JysusCrack2321/AeroPendulo/control/figuras/diagrama_bloques_pid.png

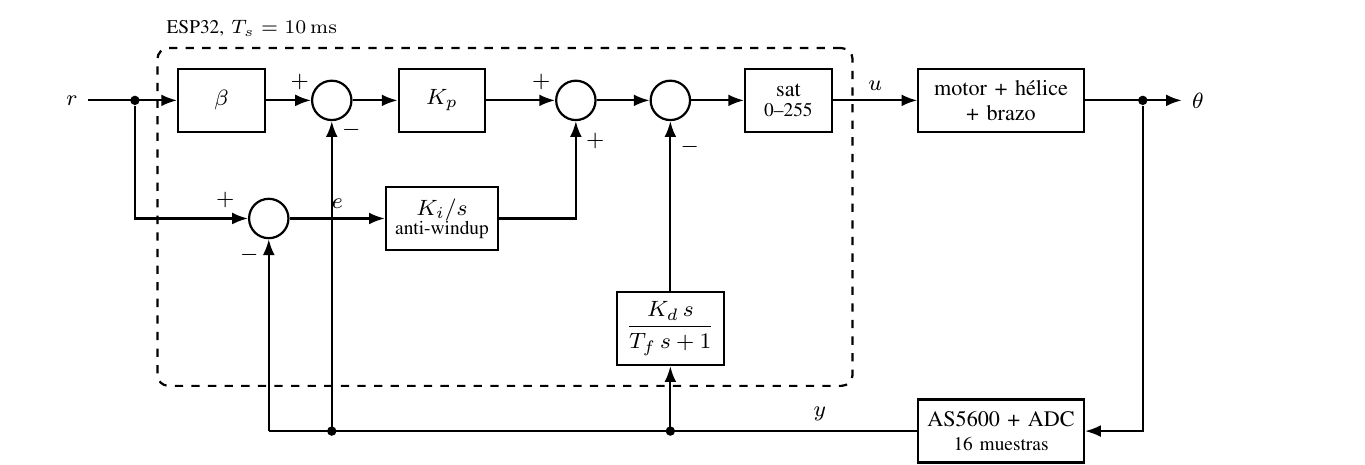
control/figuras/diagrama_bloques_pid.png
