JysusCrack2321/AeroPendulo/control/figuras/dis_01_planta.png

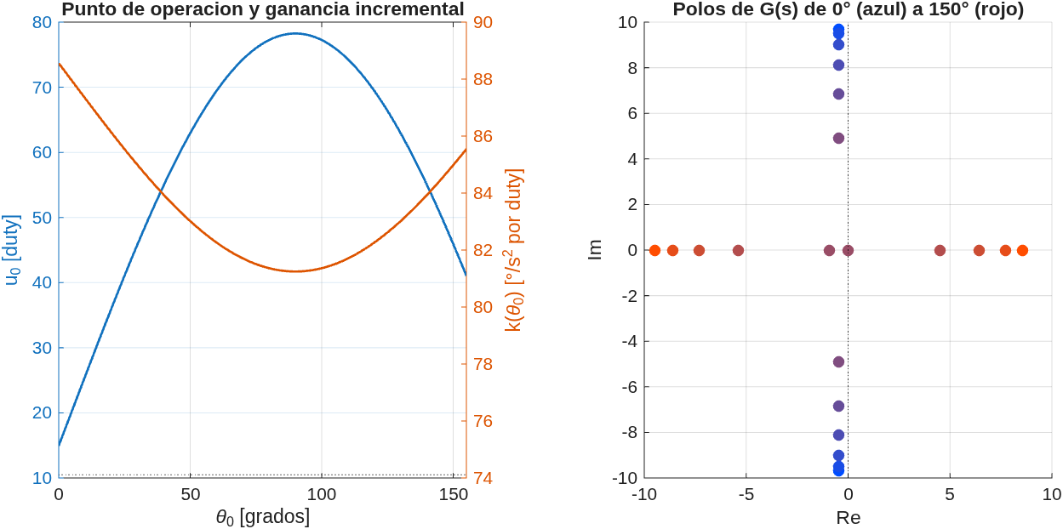
control/figuras/dis_01_planta.png
