JysusCrack2321/AeroPendulo/control/figuras/dis_02_lugar_raices.png

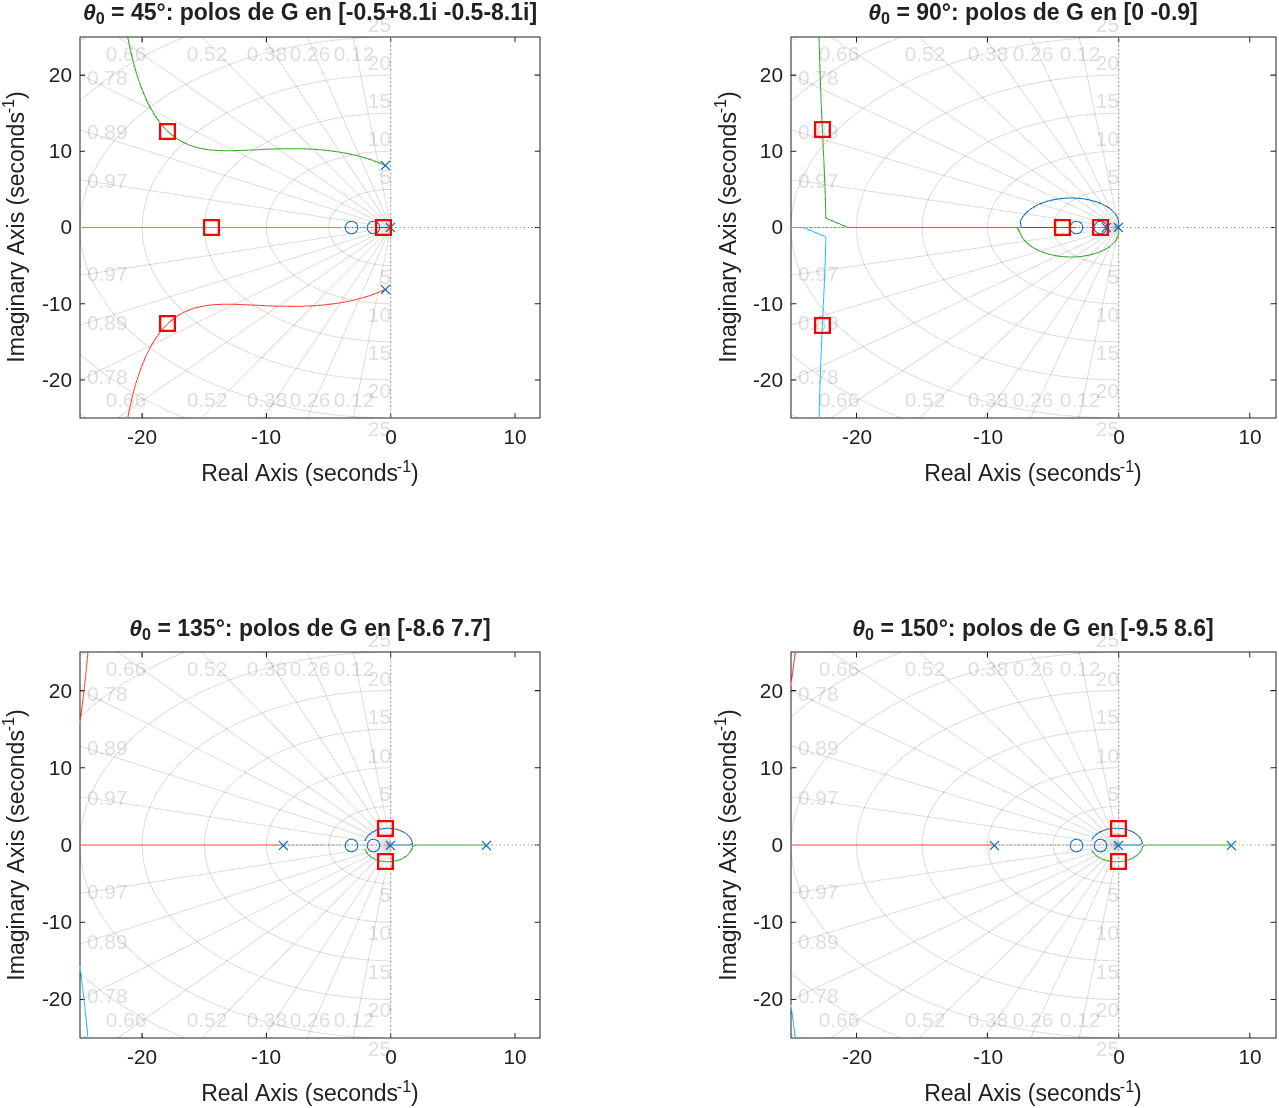
control/figuras/dis_02_lugar_raices.png
