JysusCrack2321/AeroPendulo/control/figuras/dis_03_eleccion_K.png

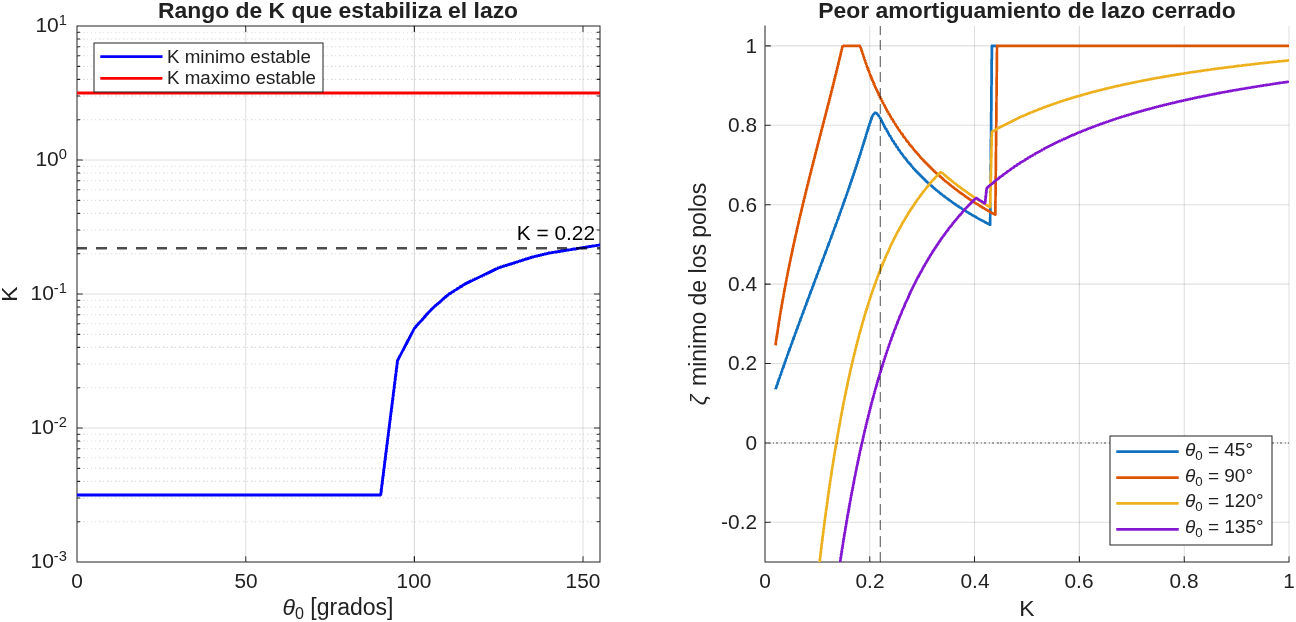
control/figuras/dis_03_eleccion_K.png
