JysusCrack2321/AeroPendulo/control/figuras/dis_05_bode.png

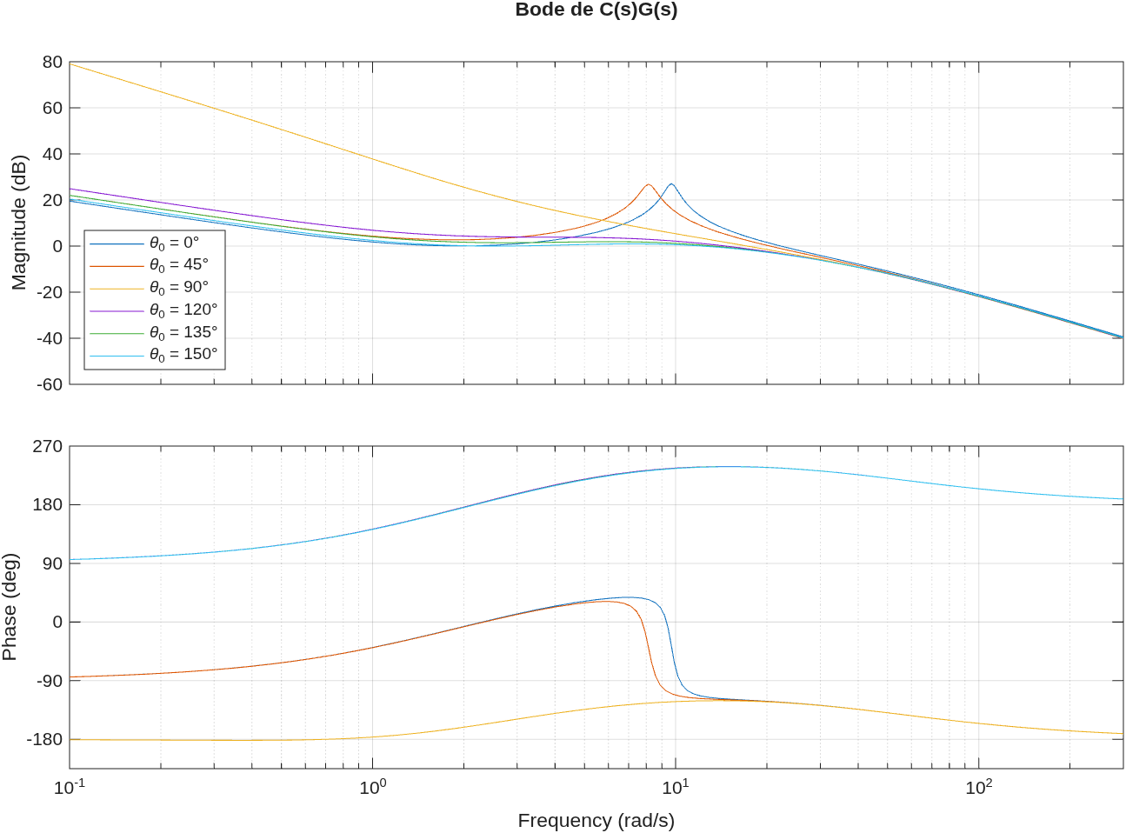
control/figuras/dis_05_bode.png
