JysusCrack2321/AeroPendulo/control/figuras/dis_06_polos_lazo_cerrado.png

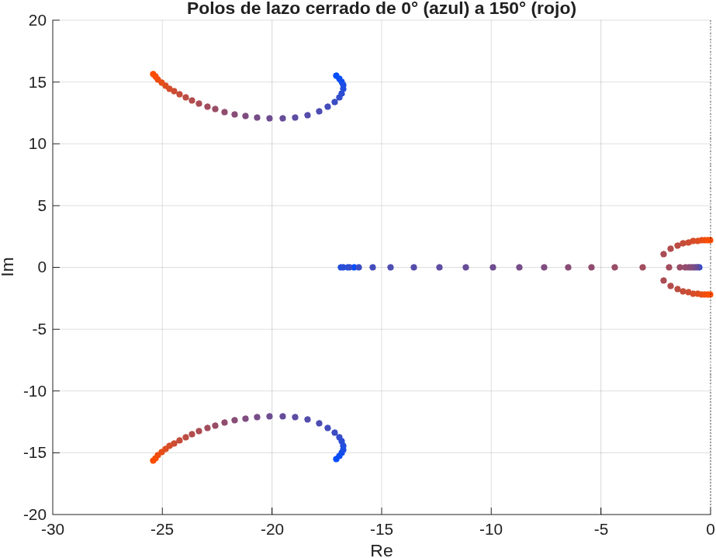
control/figuras/dis_06_polos_lazo_cerrado.png
