JysusCrack2321/AeroPendulo/control/figuras/dis_07_escalon_beta.png

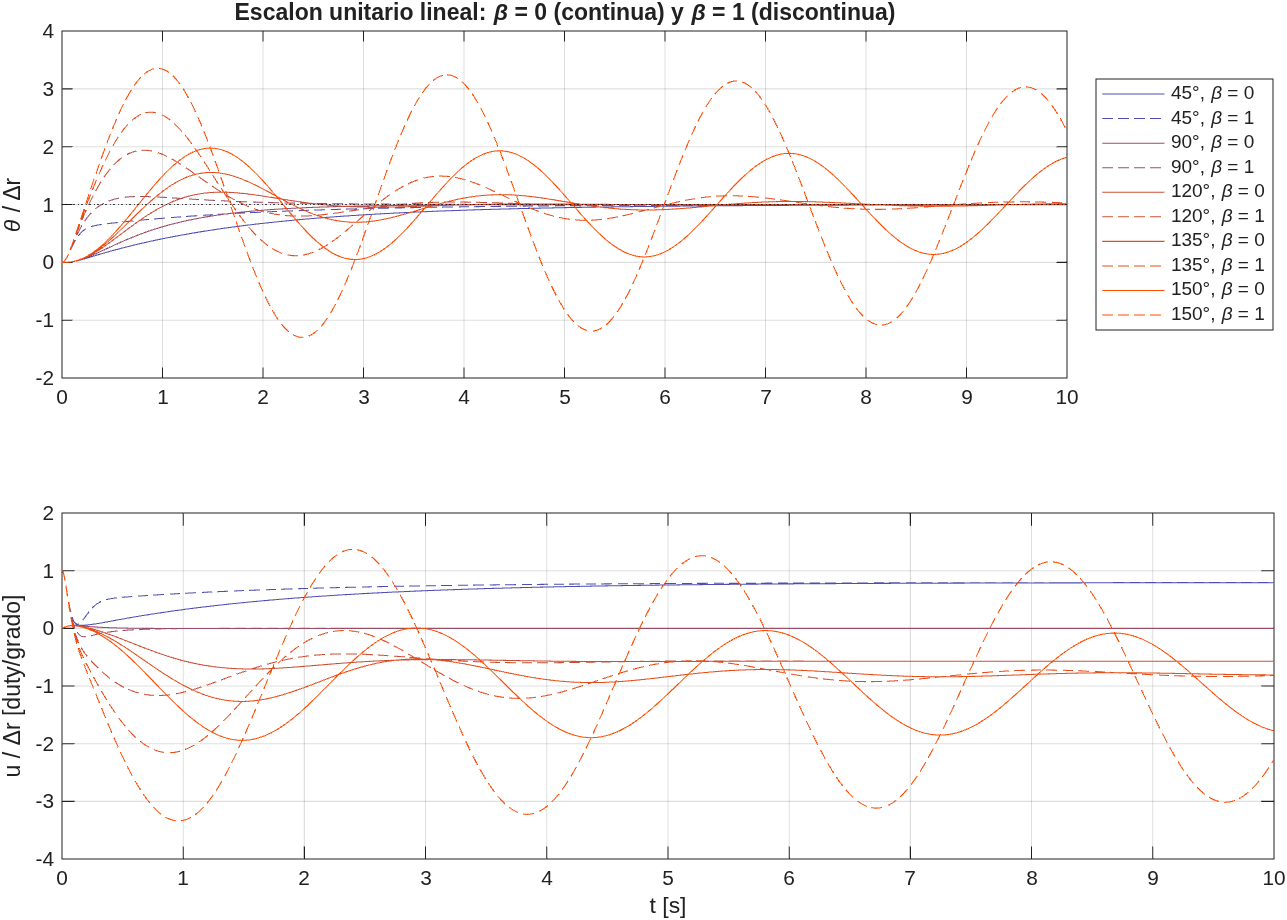
control/figuras/dis_07_escalon_beta.png
