JysusCrack2321/AeroPendulo/control/figuras/dis_09_nyquist.png

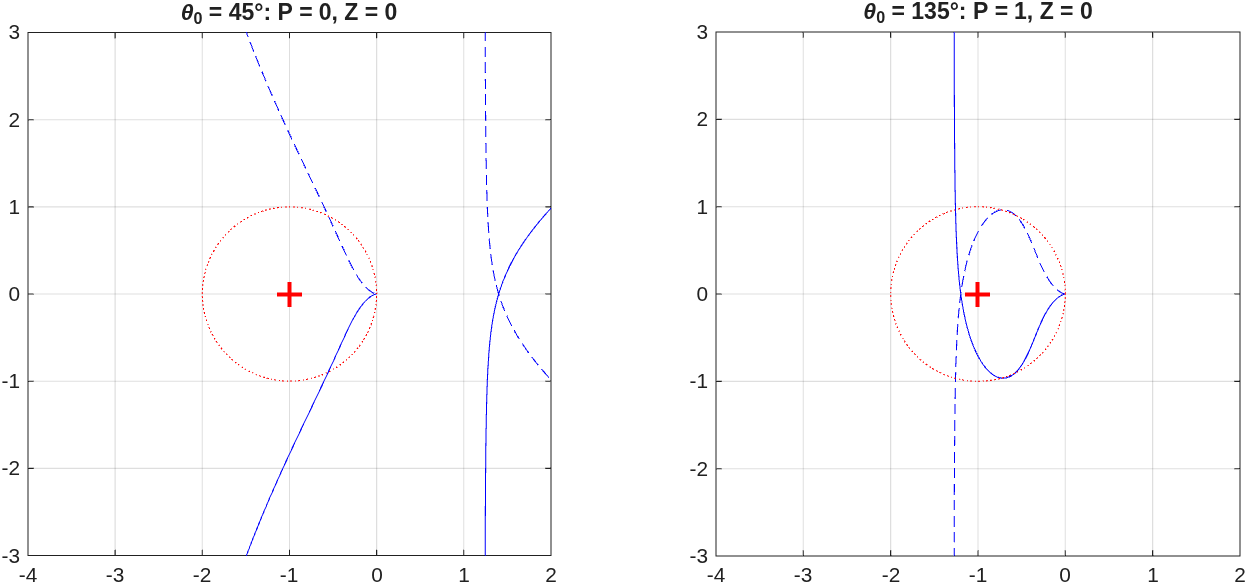
control/figuras/dis_09_nyquist.png
