JysusCrack2321/AeroPendulo/control/figuras/dis_10_sensibilidades.png

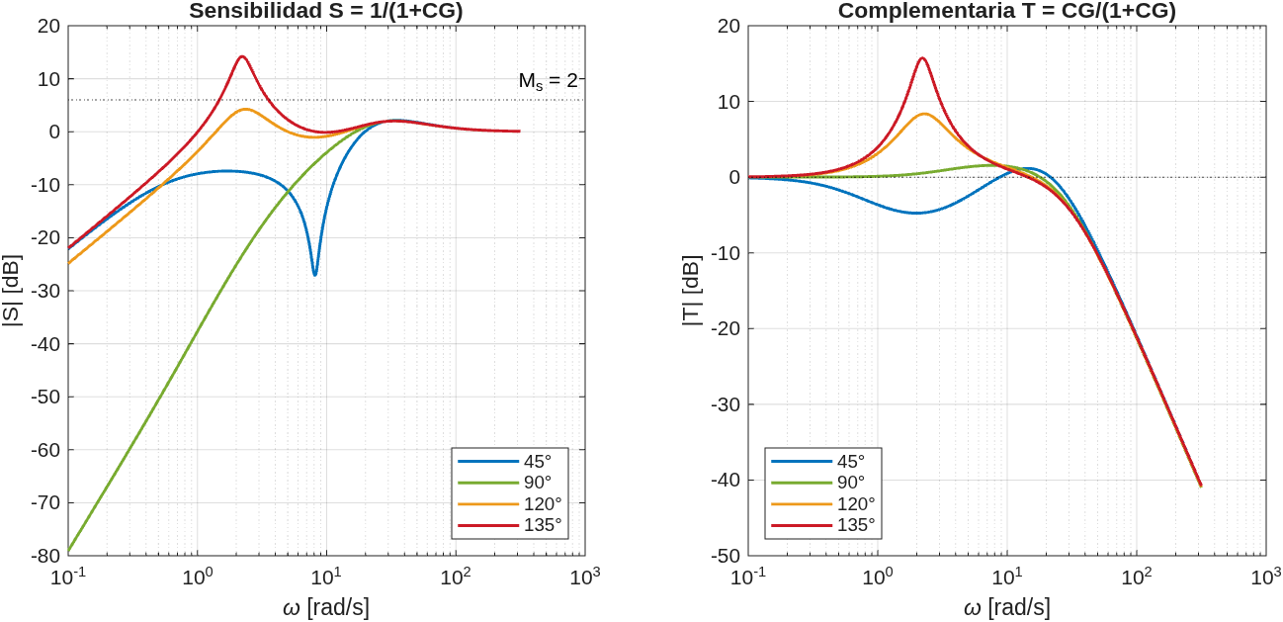
control/figuras/dis_10_sensibilidades.png
