JysusCrack2321/AeroPendulo/control/figuras/dis_11_discreto.png

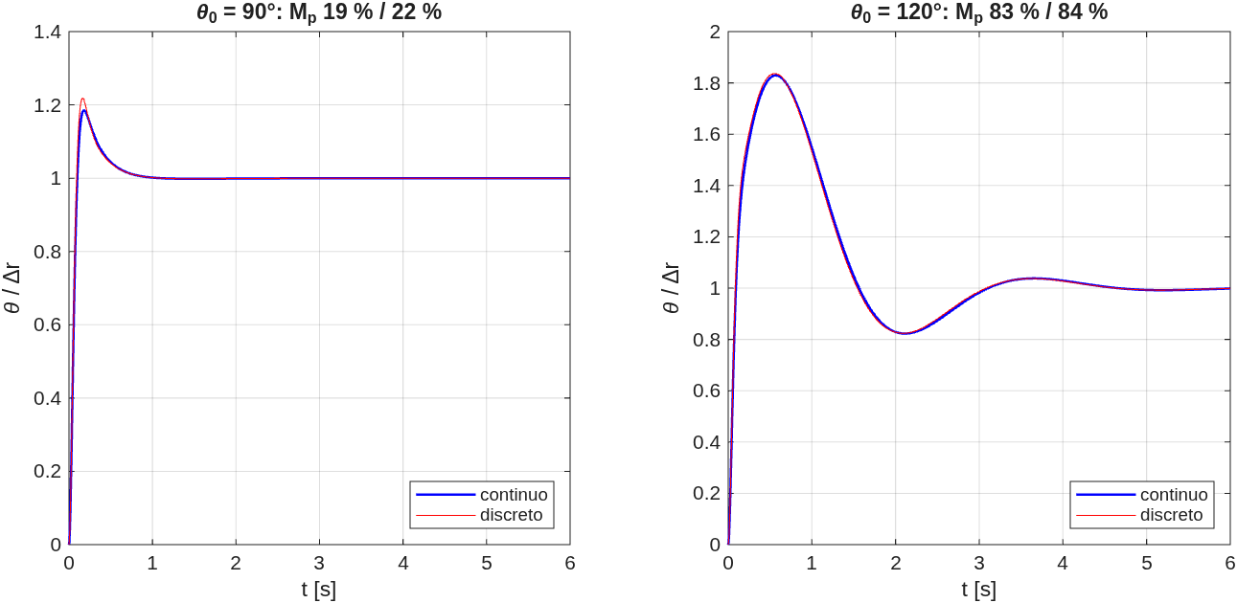
control/figuras/dis_11_discreto.png
