JysusCrack2321/AeroPendulo/control/figuras/dis_12_montecarlo.png

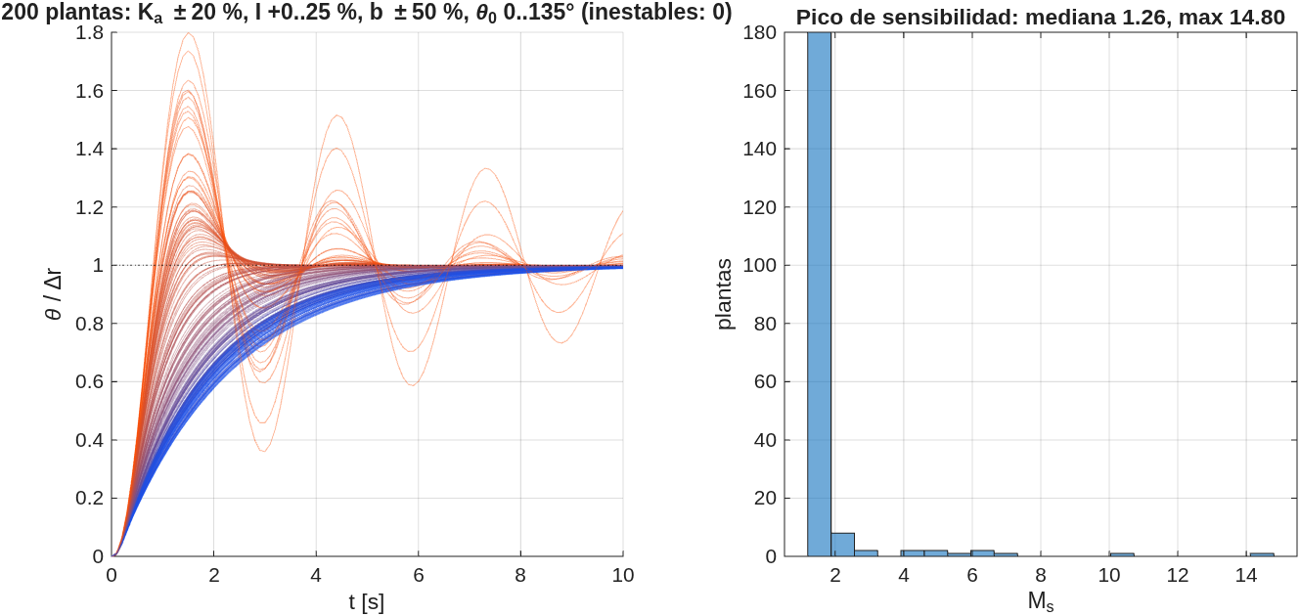
control/figuras/dis_12_montecarlo.png
