JysusCrack2321/AeroPendulo/control/figuras/exp_pid_escalones150_20261106_124411_metricas.png

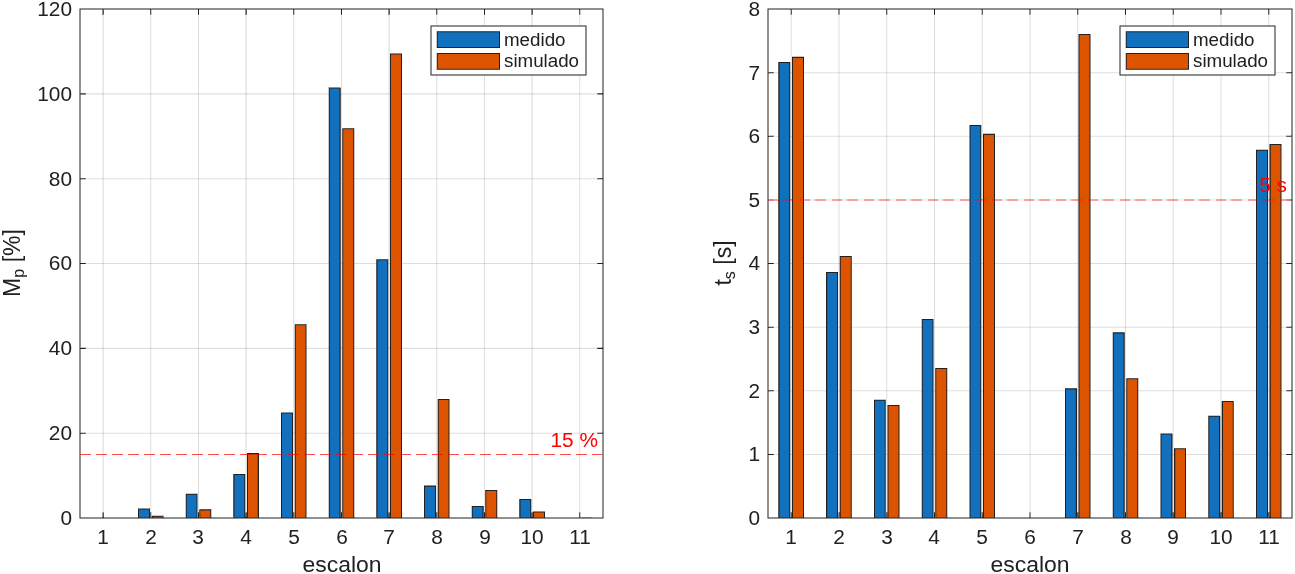
control/figuras/exp_pid_escalones150_20261106_124411_metricas.png
