JysusCrack2321/AeroPendulo/control/figuras/exp_pid_monitor_20261111_114718_metricas.png

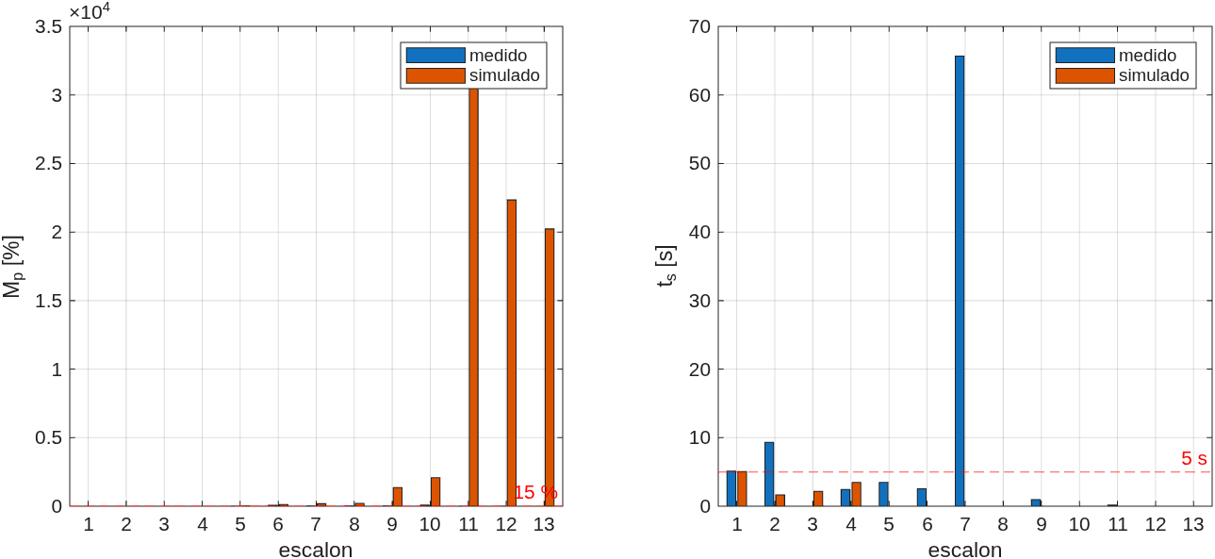
control/figuras/exp_pid_monitor_20261111_114718_metricas.png
