JysusCrack2321/AeroPendulo/control/figuras/exp_repetibilidad.png

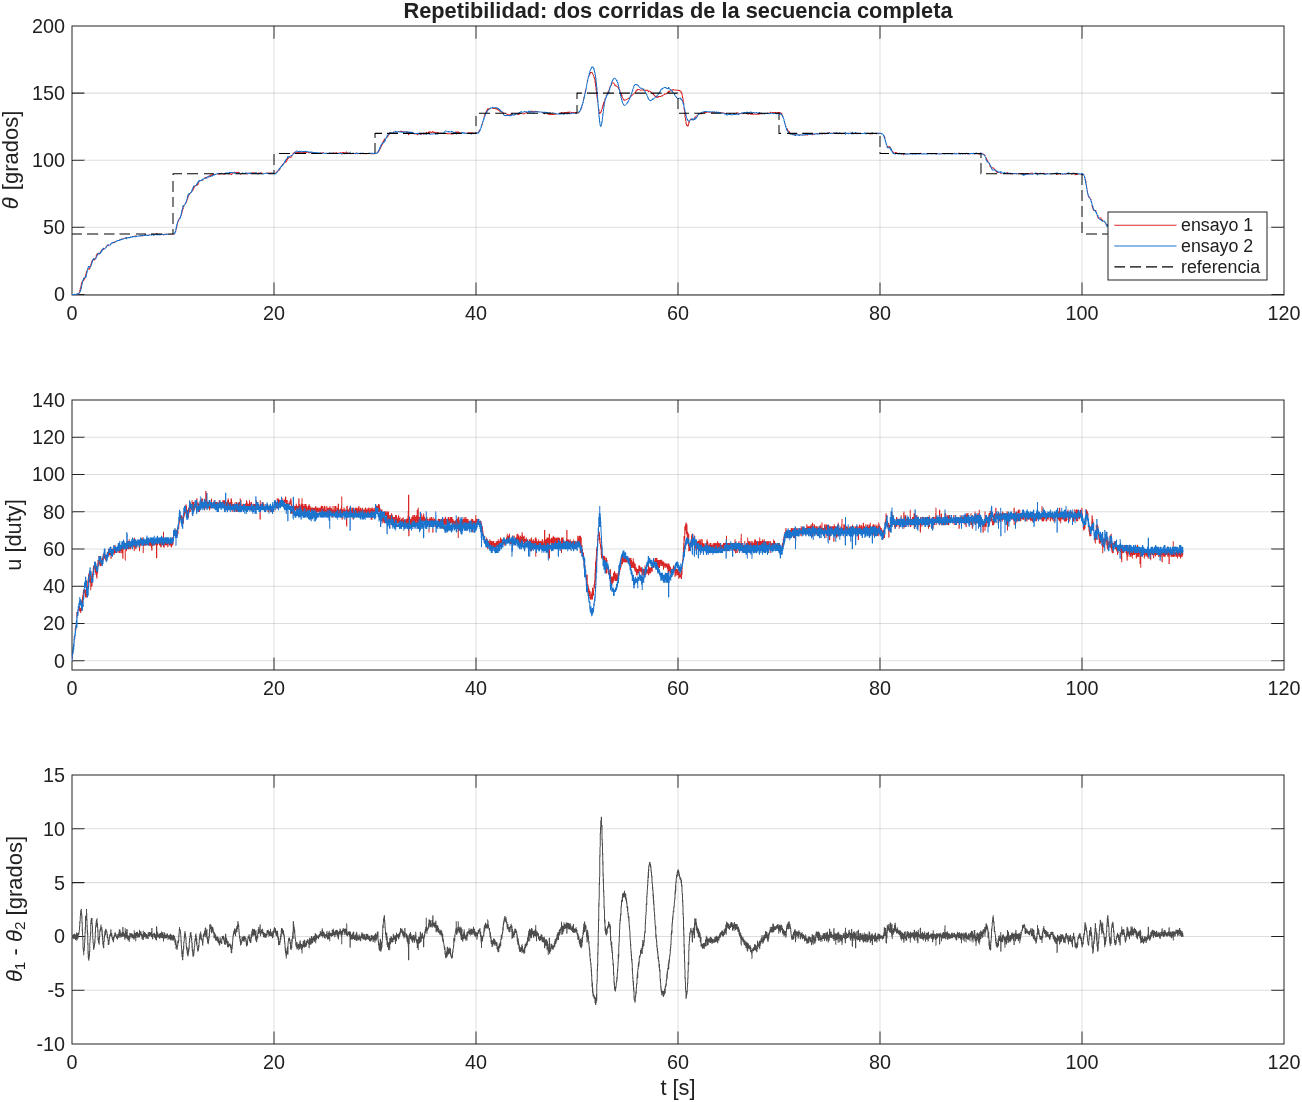
control/figuras/exp_repetibilidad.png
