JysusCrack2321/AeroPendulo/control/figuras/id_01_actuador.png

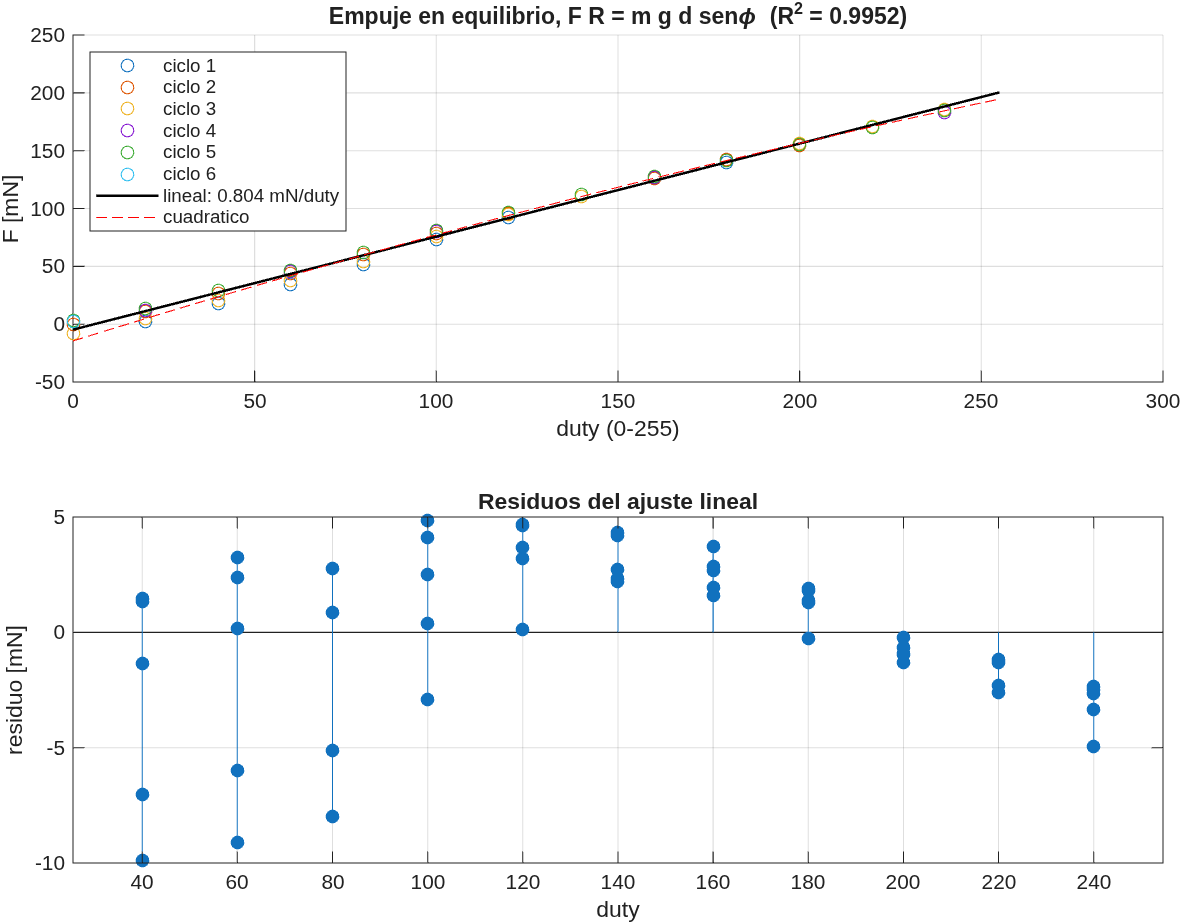
control/figuras/id_01_actuador.png
