JysusCrack2321/AeroPendulo/control/figuras/id_02_oscilacion_libre.png

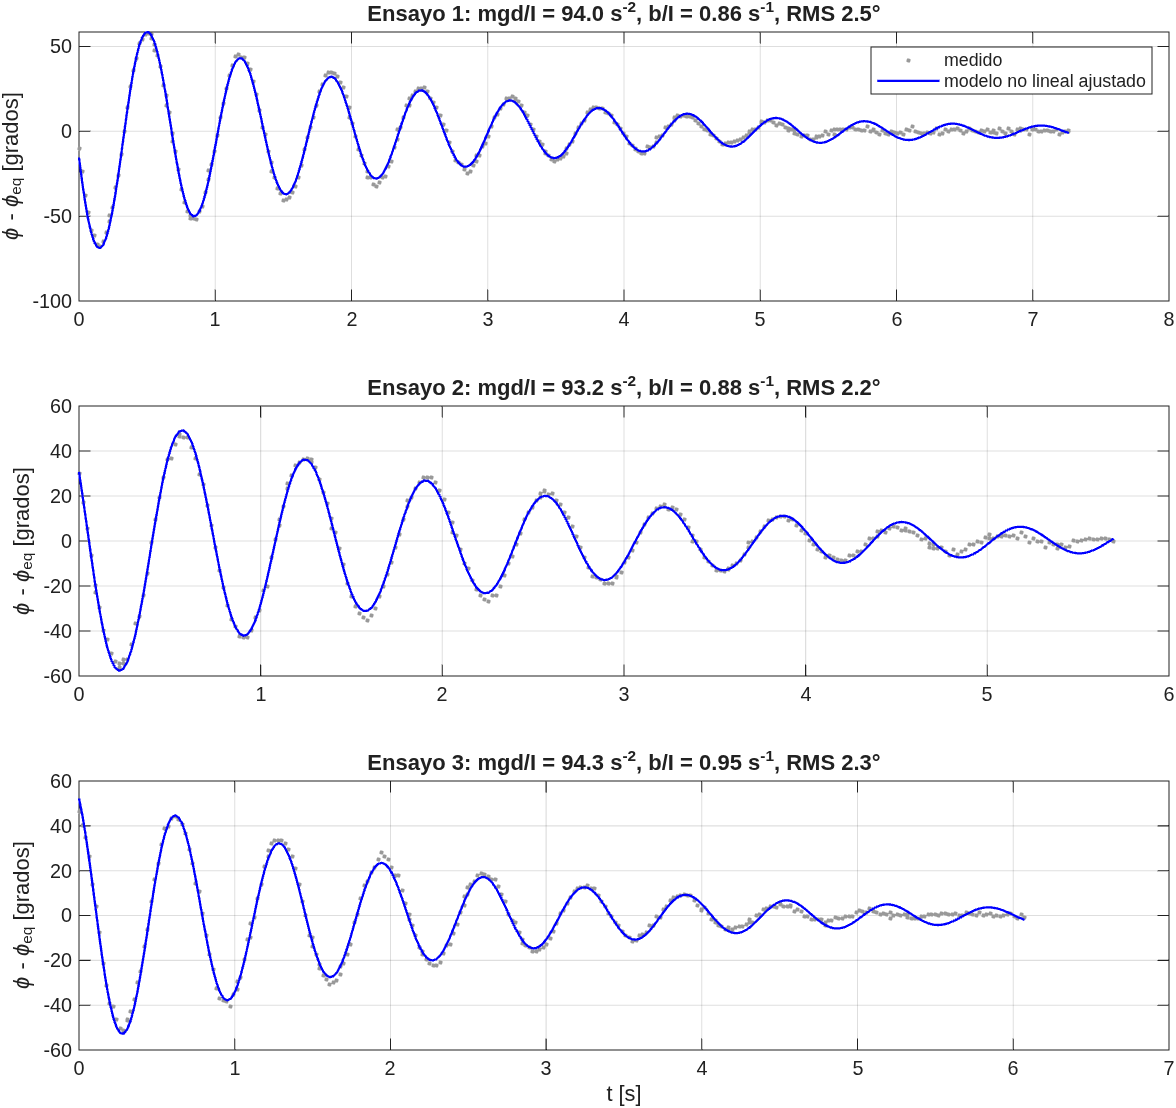
control/figuras/id_02_oscilacion_libre.png
