JysusCrack2321/AeroPendulo/control/figuras/id_03_tren_pasos.png

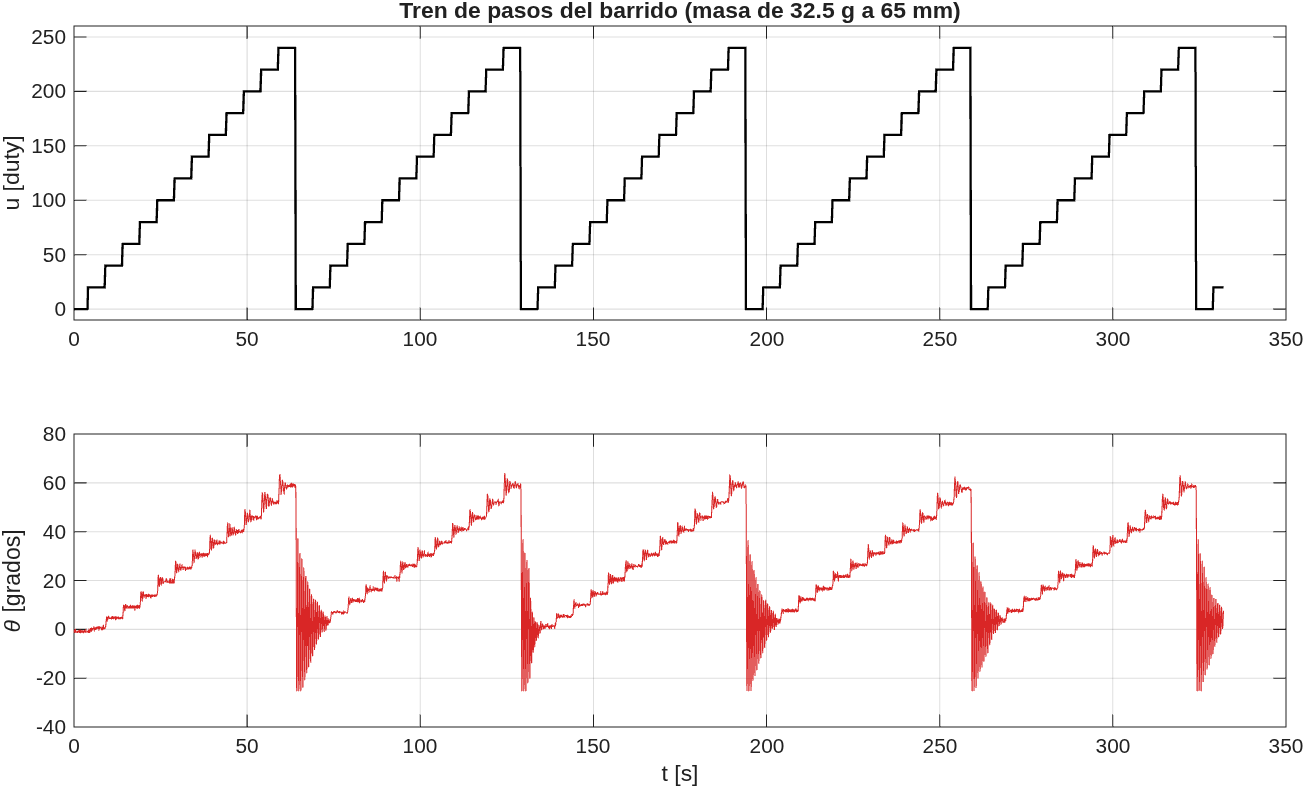
control/figuras/id_03_tren_pasos.png
