JysusCrack2321/AeroPendulo/control/figuras/id_04_angulo_pwm.png

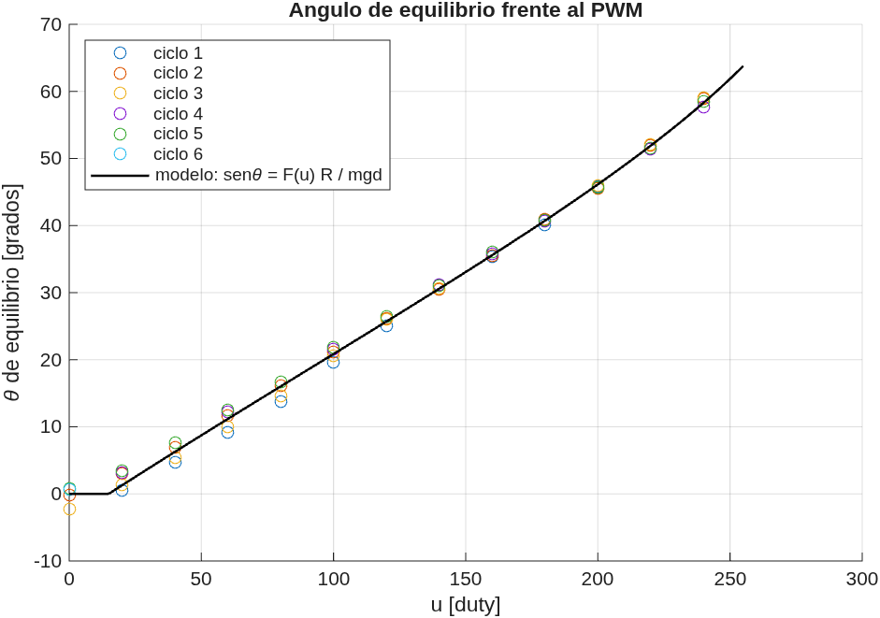
control/figuras/id_04_angulo_pwm.png
