JysusCrack2321/AeroPendulo/control/figuras/sim_01_escalones.png

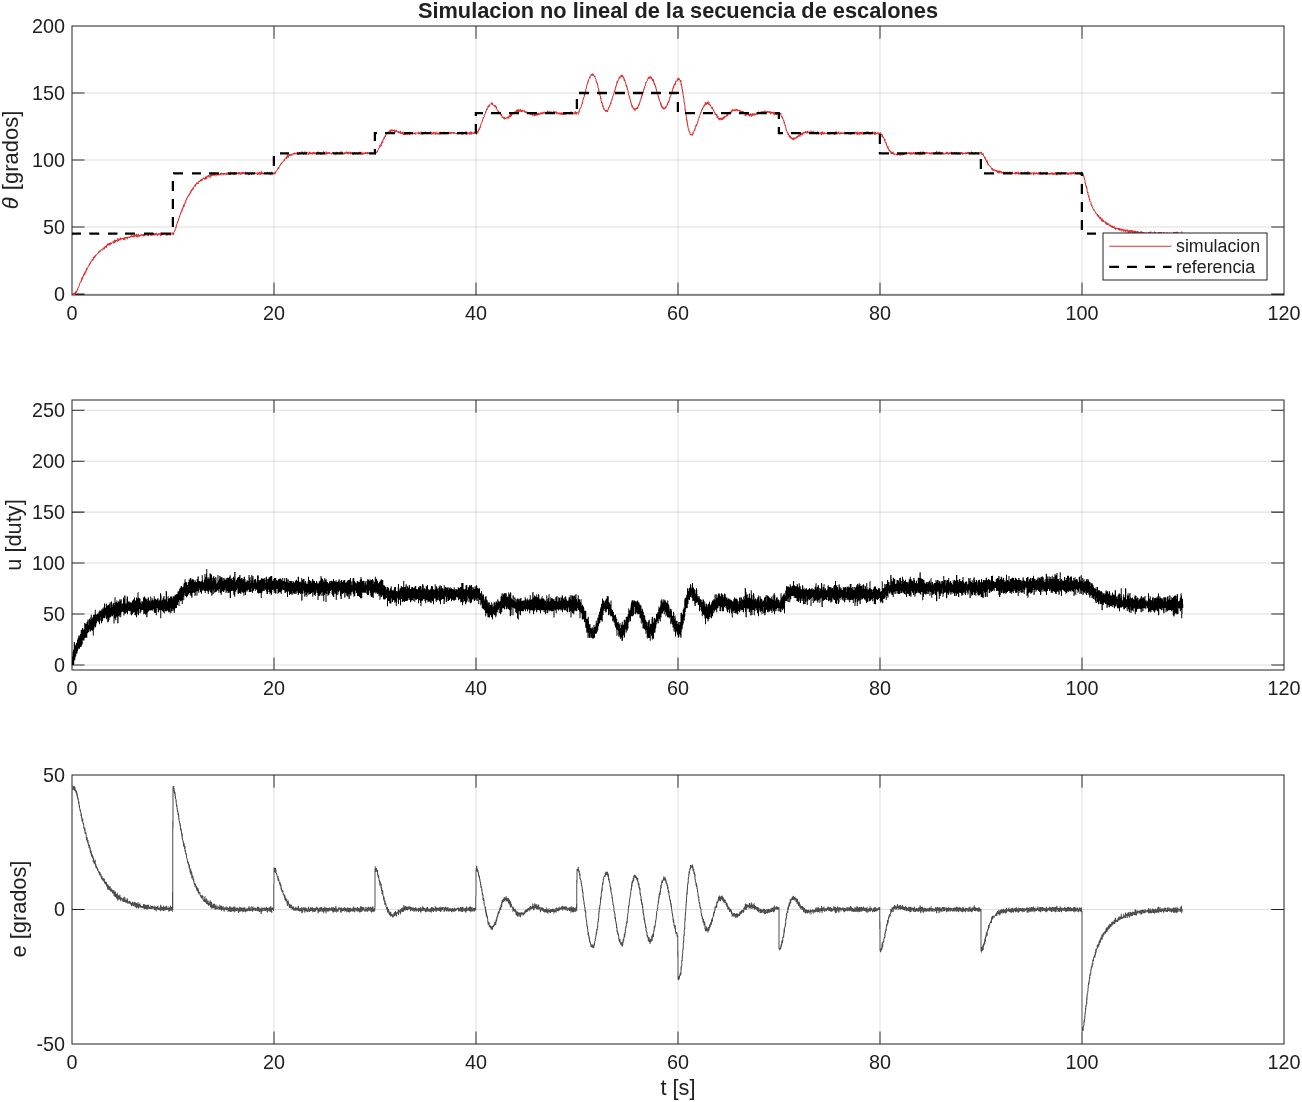
control/figuras/sim_01_escalones.png
