JysusCrack2321/AeroPendulo/control/figuras/sim_02_escalones_normalizados.png

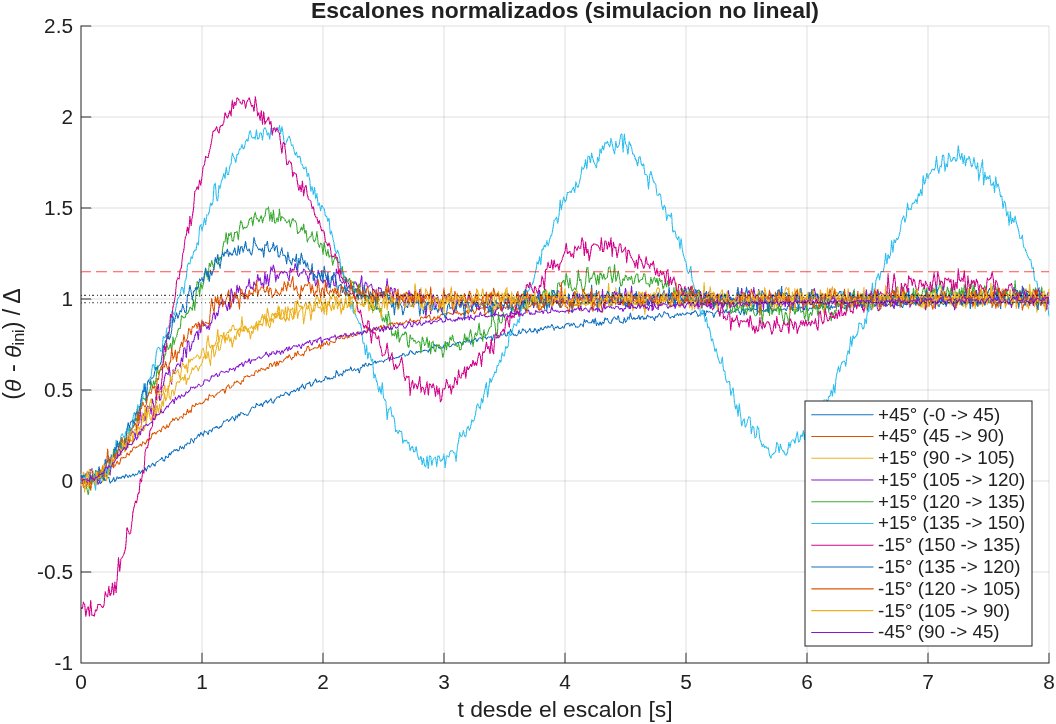
control/figuras/sim_02_escalones_normalizados.png
