JysusCrack2321/AeroPendulo/control/figuras/sim_03_perturbacion.png

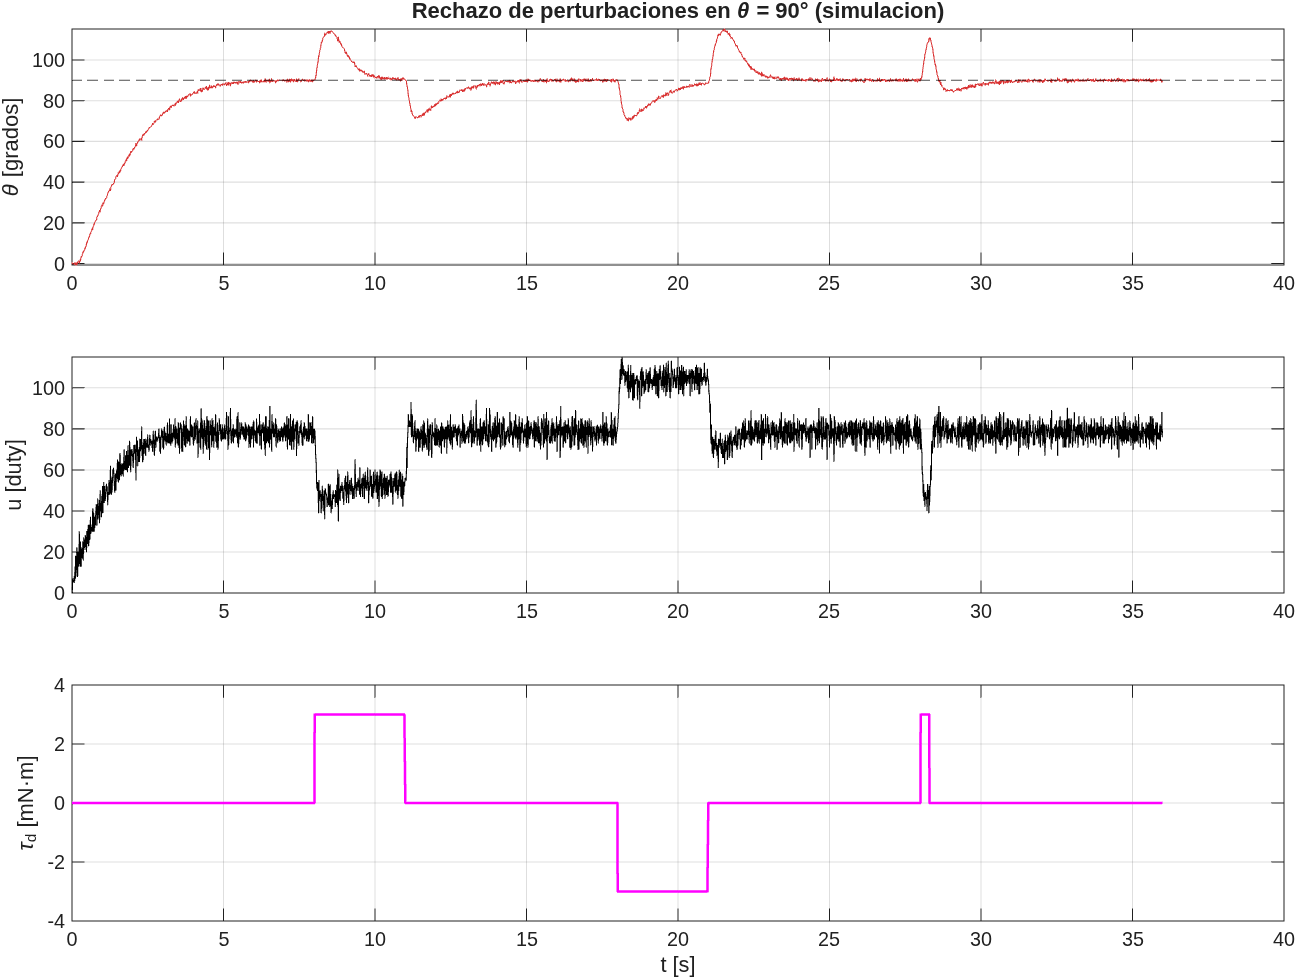
control/figuras/sim_03_perturbacion.png
