JysusCrack2321/AeroPendulo/control/figuras/sim_04_robustez.png

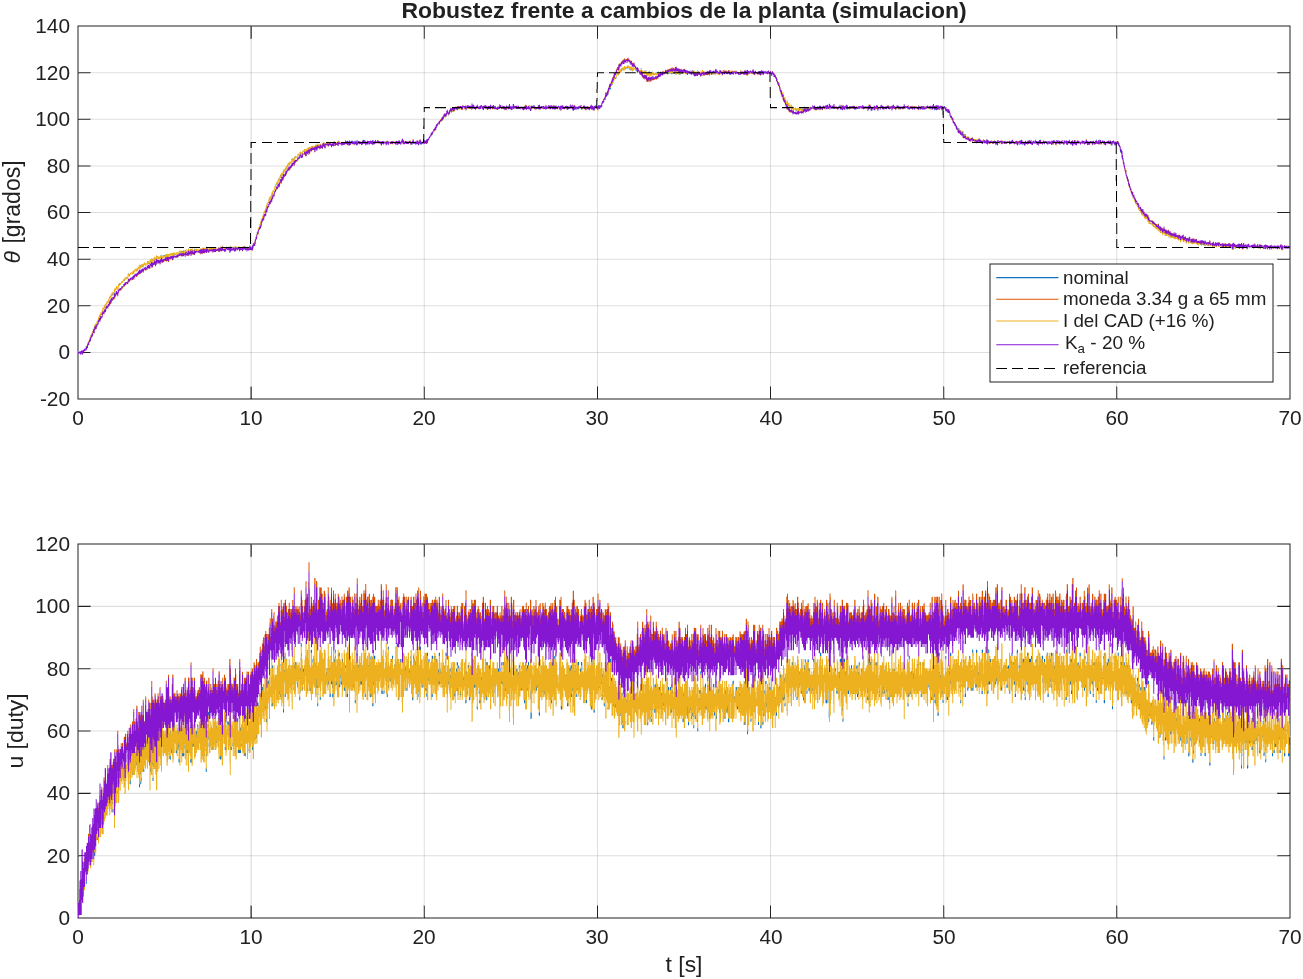
control/figuras/sim_04_robustez.png
