JysusCrack2321/AeroPendulo/control/figuras/sim_05_simulink.png

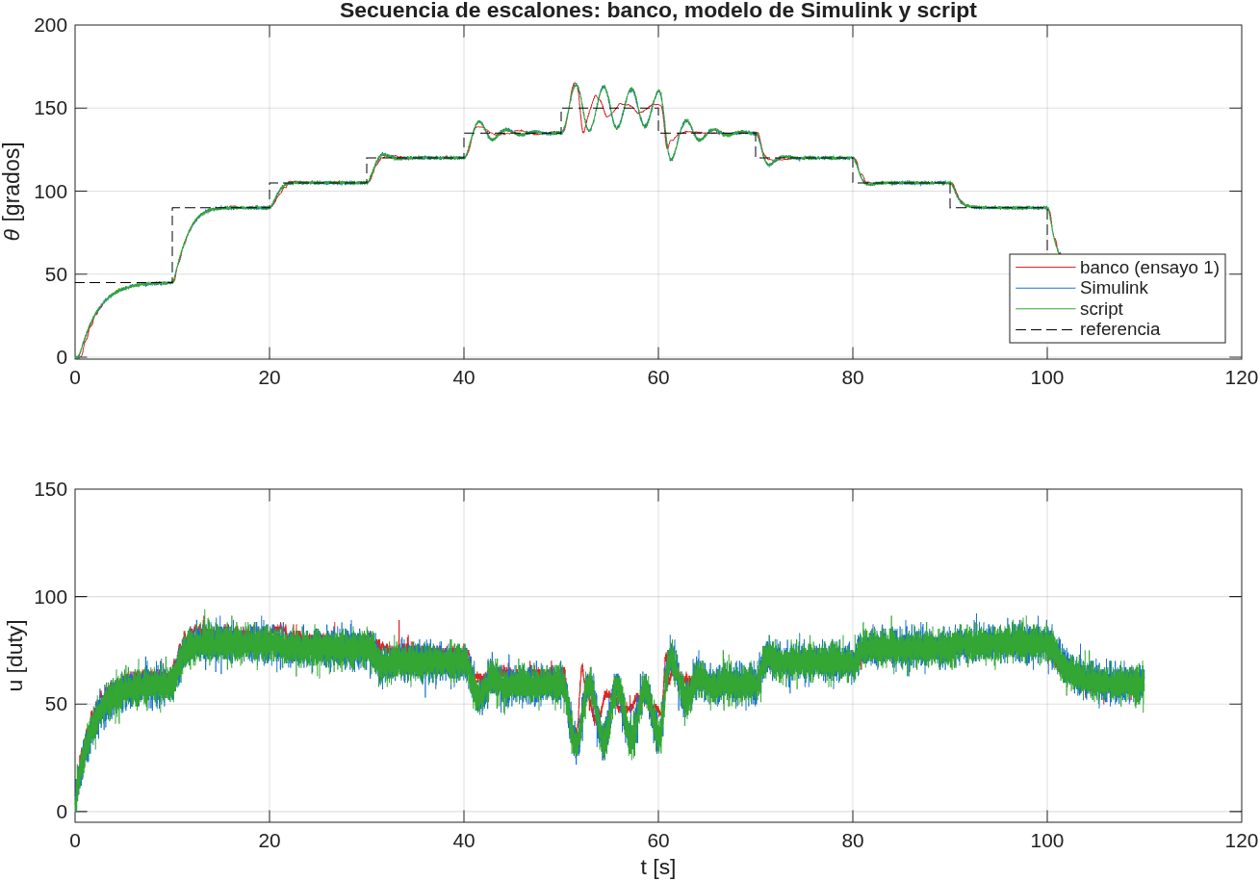
control/figuras/sim_05_simulink.png
