JysusCrack2321/AeroPendulo/control/figuras/simulink_modelo.png

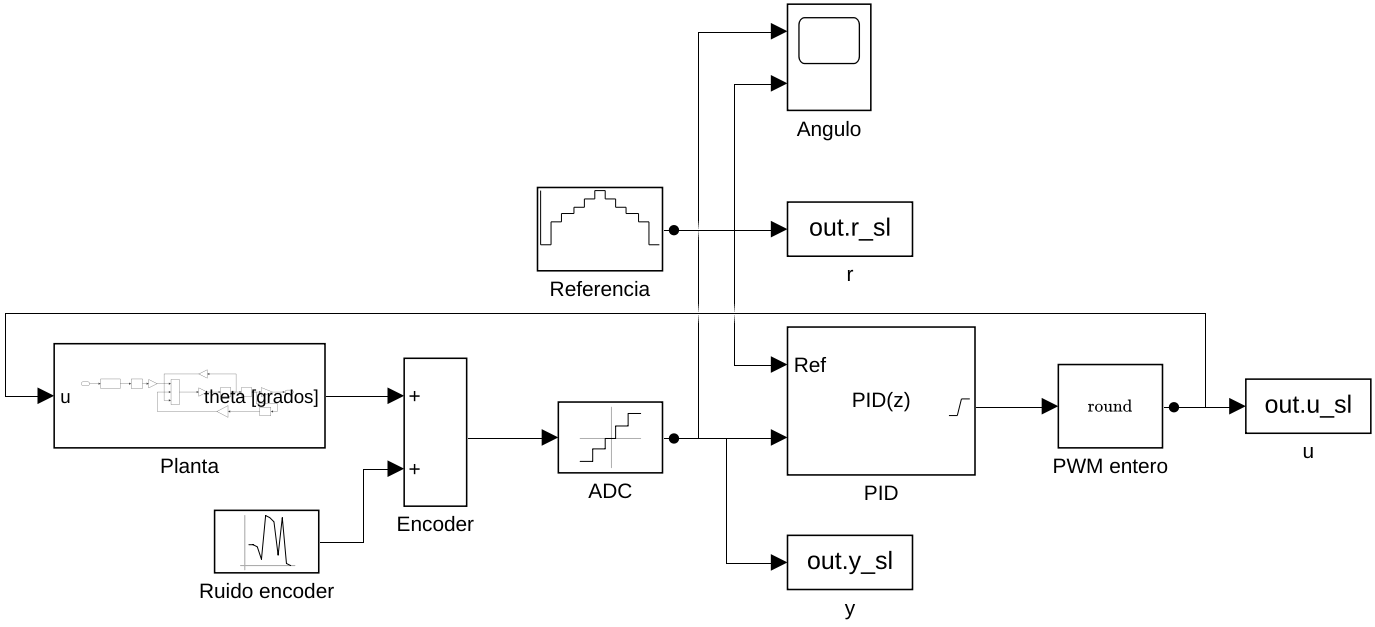
control/figuras/simulink_modelo.png
