JysusCrack2321/AeroPendulo/control/figuras/simulink_planta.png

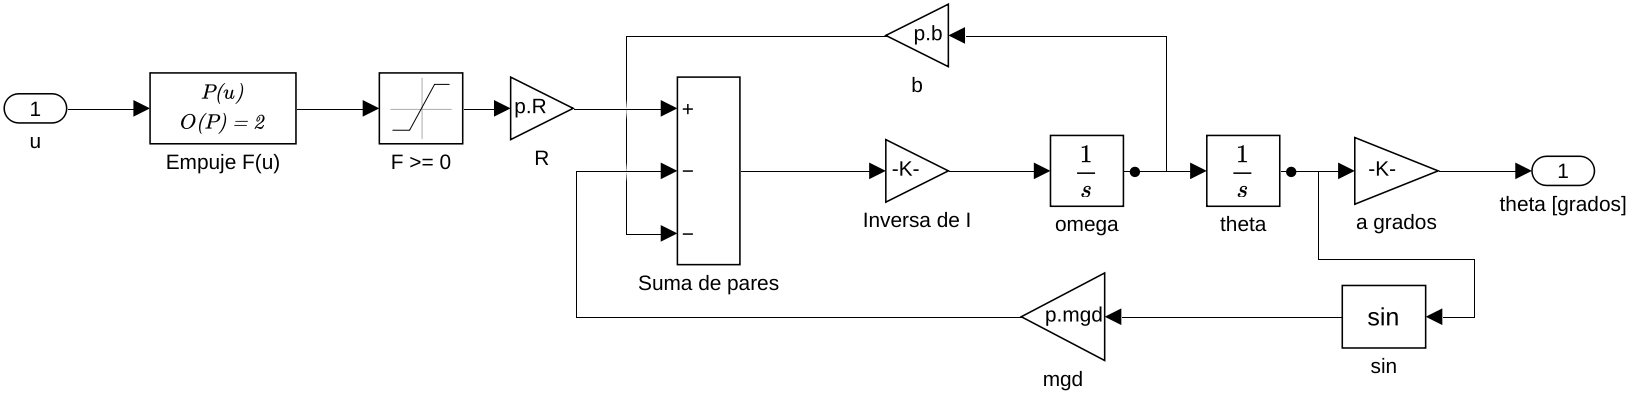
control/figuras/simulink_planta.png
