JysusCrack2321/AeroPendulo/docs/imagenes/decaimiento-20261105.png

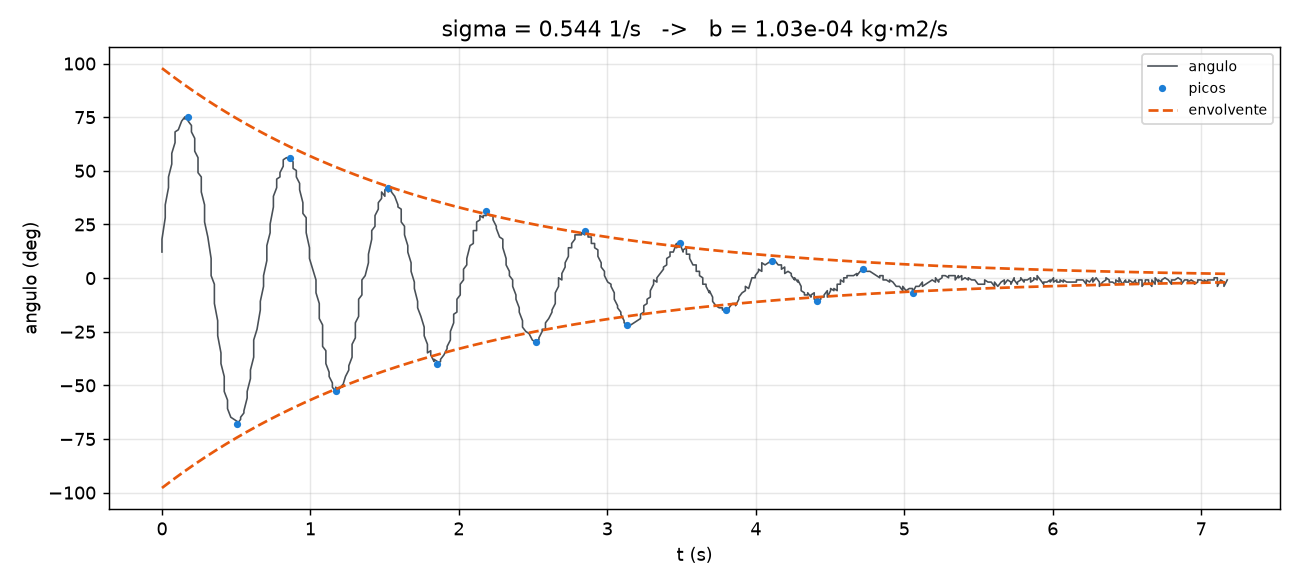
docs/imagenes/decaimiento-20261105.png
