JysusCrack2321/AeroPendulo/modelado/ensamble.step

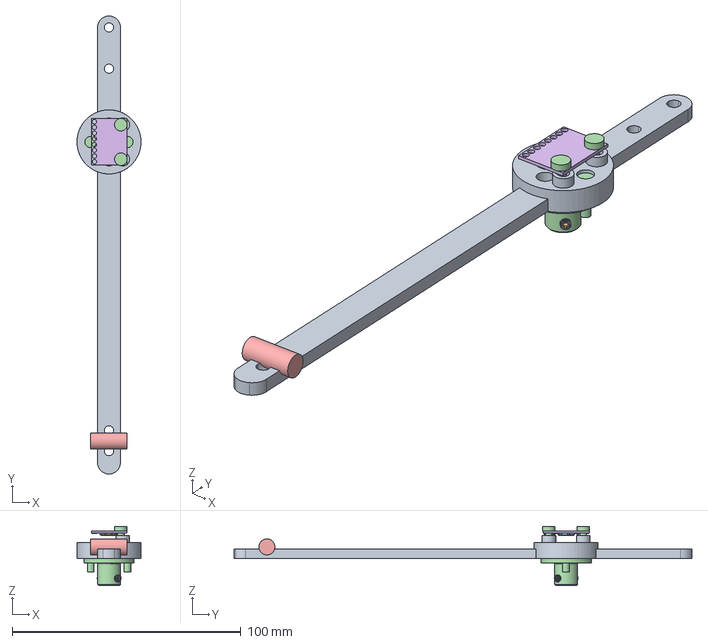
[picture p31: CAD file, 2026-11-05]
modelado/ensamble.step
28.0 x 200.0 x 25.9 mm
