JysusCrack2321/AeroPendulo/modelado/steps/mpu.step

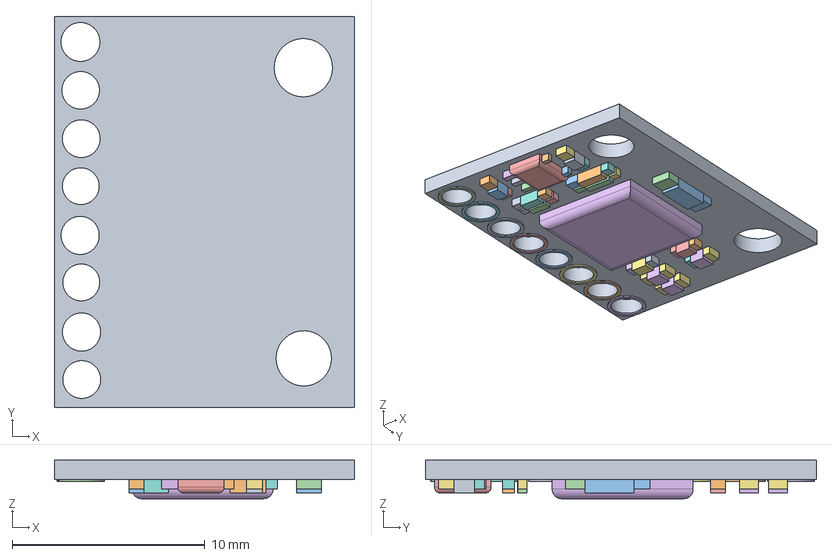
[picture p32: CAD file, 2026-11-05]
modelado/steps/mpu.step
15.6 x 20.3 x 2.00 mm
