JysusCrack2321/AeroPendulo/modelado/Estructura-Pendulo-3D.step

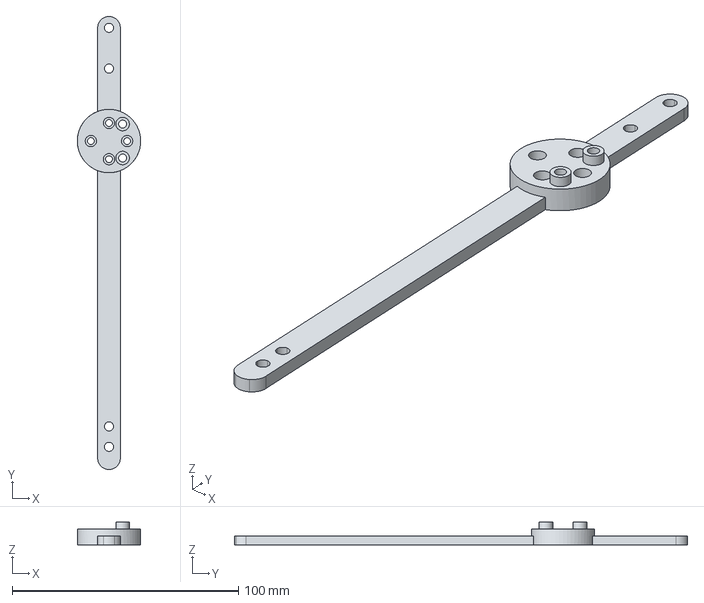
[picture p33: CAD file, 2026-11-05]
modelado/Estructura-Pendulo-3D.step
28.0 x 200.0 x 10.0 mm
