JysusCrack2321/AeroPendulo/modelado/steps/motor.step

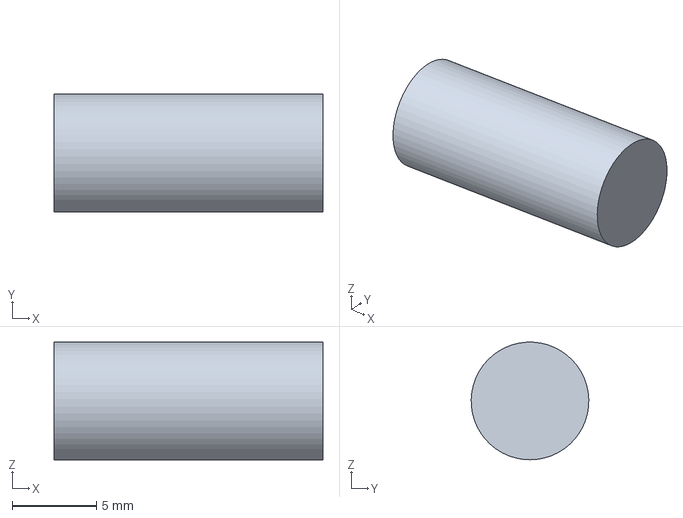
[picture p34: CAD file, 2026-11-05]
modelado/steps/motor.step
16.0 x 7.00 x 6.99 mm
