JysusCrack2321/AeroPendulo/modelado/steps/brida.step

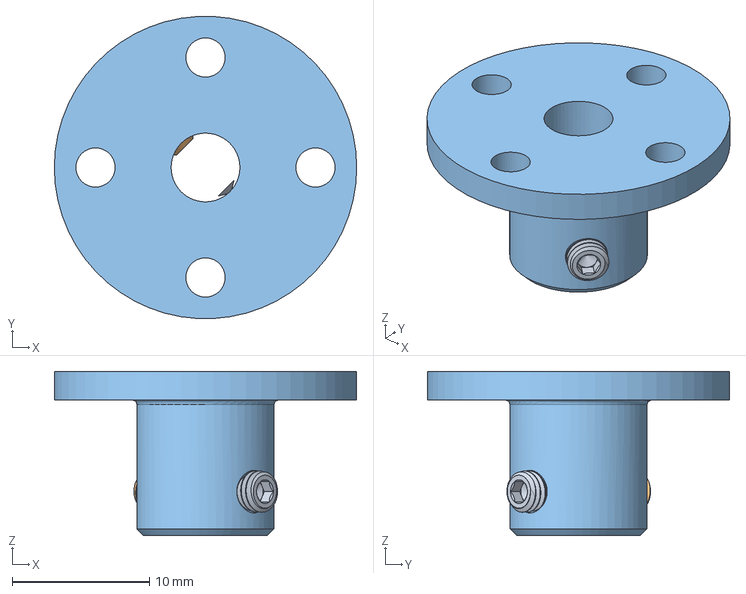
[picture p35: CAD file, 2026-11-05]
modelado/steps/brida.step
22.0 x 22.0 x 11.9 mm
