JysusCrack2321/AeroPendulo/modelado/steps/tornillos.step

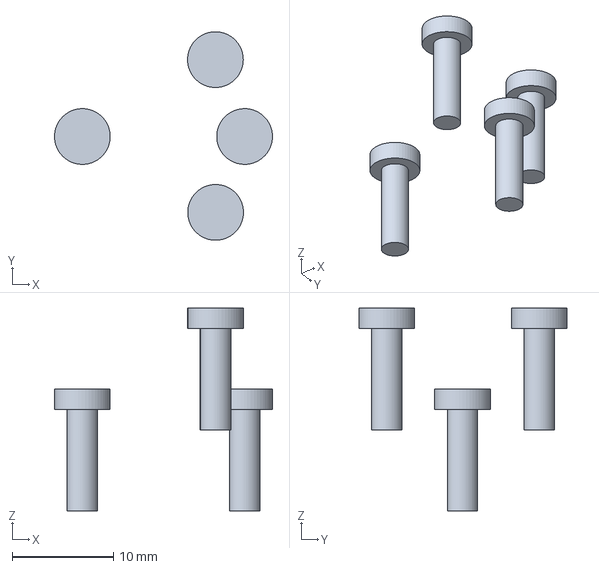
[picture p36: CAD file, 2026-11-05]
modelado/steps/tornillos.step
21.5 x 20.6 x 20.0 mm
