JysusCrack2321/AeroPendulo/(list of files, cad)

Other CAD files:
modelado/steps/brazo.step
modelado/ensamble.FCStd
