JysusCrack2321/AeroPendulo/docs/imagenes/ensamble.png

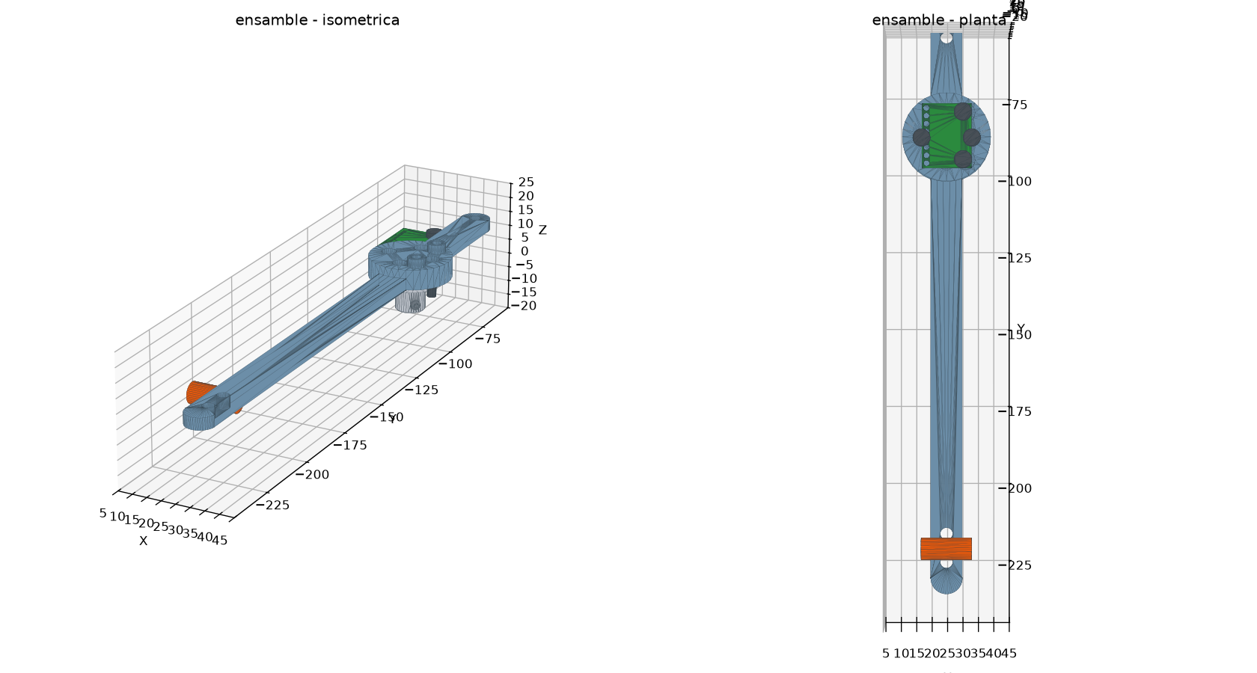
docs/imagenes/ensamble.png
