JysusCrack2321/AeroPendulo/control/resultados/metricas_pid_escalones150_20261106_124411.csv

paso | desde | hasta | delta | tr_s | Mp_pct | ts_s | ess_grados | IAE | u_max | u_ss
1 | 0.004 | 45 | 44.996 | 3.87 | 0 | 7.16 | 0.3157 | 108.258399999998 | 69 | 63.435
2 | 45 | 90 | 45 | 2.62 | 2.1144444444444 | 3.86 | -0.34875 | 67.1521999999985 | 91 | 82.555
3 | 90 | 105 | 15 | 1.46 | 5.62666666666671 | 1.85 | 0.0423500000000002 | 18.2359999999996 | 88 | 80.04
4 | 105 | 120 | 15 | 0.990000000000002 | 10.2533333333332 | 3.12 | -0.3906 | 16.4765999999997 | 89 | 73.825
5 | 120 | 135 | 15 | 0.580000000000005 | 24.7700000000001 | 6.17 | -0.3119 | 18.5136999999996 | 76 | 63.2
6 | 135 | 150 | 15 | 0.449999999999996 | 101.39 | Inf | -0.1285 | 46.756199999999 | 69 | 50.125
7 | 150 | 135 | -15 | 0.25 | 60.9099999999999 | 2.03 | -0.0582000000000002 | 18.2172999999996 | 74 | 62.145
8 | 135 | 120 | -15 | 0.620000000000005 | 7.51999999999999 | 2.91 | 0.1604 | 12.8596999999997 | 76 | 70.44
9 | 120 | 105 | -15 | 0.899999999999991 | 2.73999999999992 | 1.31999999999999 | 0.14855 | 13.0077999999997 | 82 | 75.75
10 | 105 | 90 | -15 | 1.15000000000001 | 4.39333333333327 | 1.59999999999999 | 0.2397 | 14.9680999999997 | 83 | 78
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
