JysusCrack2321/AeroPendulo/control/resultados/metricas_pid_escalones150_20261106_124411_sim.csv

paso | desde | hasta | delta | tr_s | Mp_pct | ts_s | ess_grados | IAE | u_max | u_ss
1 | -0.175824175824176 | 45 | 45.1758241758242 | 4.05 | 0.024324981756263 | 7.24 | 0.368791208791204 | 103.753846153844 | 72 | 58.875
2 | 45 | 90 | 45 | 2.6 | 0.410256410256449 | 4.11 | -0.00439560439561149 | 66.0360439560424 | 95 | 78.315
3 | 90 | 105 | 15 | 1.3 | 1.91941391941404 | 1.77 | 0.0131868131868026 | 15.6054945054941 | 87 | 76.035
4 | 105 | 120 | 15 | 0.84 | 15.1794871794873 | 2.35 | -0.0171428571428704 | 14.5081318681315 | 86 | 69.445
5 | 120 | 135 | 15 | 0.640000000000001 | 45.5531135531135 | 6.03 | 0.172747252747249 | 22.521538461538 | 78 | 59.3
6 | 135 | 150 | 15 | 0.539999999999999 | 91.78021978022 | Inf | 3.26241758241757 | 81.492307692306 | 68 | 49.01
7 | 150 | 135 | -15 | 0.219999999999999 | 109.406593406593 | 7.59999999999999 | -0.279120879120882 | 44.1008791208782 | 80 | 58.93
8 | 135 | 120 | -15 | 0.590000000000003 | 27.92673992674 | 2.19 | 0.00835164835163532 | 14.5081318681316 | 82 | 69.475
9 | 120 | 105 | -15 | 0.800000000000011 | 6.49084249084231 | 1.09 | -0.0316483516483621 | 12.6982417582415 | 91 | 75.965
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
