JysusCrack2321/AeroPendulo/control/resultados/metricas_pid_escalones150_20261106_124828.csv

paso | desde | hasta | delta | tr_s | Mp_pct | ts_s | ess_grados | IAE | u_max | u_ss
1 | -0.042 | 45 | 45.042 | 3.87 | 0.0504579564124086 | 7.27 | 0.336 | 109.391799999998 | 69 | 64.49
2 | 45 | 90 | 45 | 2.59 | 1.73111111111111 | 4.07 | -0.10985 | 65.2456999999986 | 90 | 81.875
3 | 90 | 105 | 15 | 1.37 | 11.59 | 3.83 | -0.0646500000000001 | 18.2780999999996 | 88 | 78.185
4 | 105 | 120 | 15 | 0.949999999999999 | 10.4966666666668 | 7.73 | -0.0769500000000001 | 16.2736999999997 | 84 | 71.91
5 | 120 | 135 | 15 | 0.579999999999998 | 28.4666666666666 | 5.78 | 0.336849999999999 | 19.9230999999996 | 76 | 61.75
6 | 135 | 150 | 15 | 0.520000000000003 | 128.786666666667 | Inf | -1.41605 | 65.6816999999986 | 83 | 46.715
7 | 150 | 135 | -15 | 0.719999999999999 | 38.5 | 5.42 | 0.160999999999999 | 16.3469999999996 | 68 | 60.44
8 | 135 | 120 | -15 | 0.560000000000002 | 9.22333333333303 | 2.53 | 0.0672499999999994 | 11.9330999999997 | 77 | 69.34
9 | 120 | 105 | -15 | 0.879999999999995 | 3.00666666666662 | 1.28 | 0.1414 | 12.8855999999997 | 82 | 75.71
10 | 105 | 90 | -15 | 1.31999999999999 | 6.75999999999988 | 4.27 | -0.0224000000000001 | 15.3147999999997 | 85 | 78.25
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
