JysusCrack2321/AeroPendulo/control/resultados/metricas_pid_escalones150_20261106_124828_sim.csv

paso | desde | hasta | delta | tr_s | Mp_pct | ts_s | ess_grados | IAE | u_max | u_ss
1 | -0.193406593406593 | 45 | 45.1934065934066 | 4.07 | 0.0596835445836108 | 7.39 | 0.381978021978018 | 103.790769230767 | 71 | 58.865
2 | 45 | 90 | 45 | 2.6 | 0.371184371184374 | 4.2 | 0.020219780219773 | 66.0487912087897 | 95 | 78.315
3 | 90 | 105 | 15 | 1.3 | 1.97802197802199 | 1.76 | 0.0254945054944947 | 15.5582417582414 | 87 | 76.035
4 | 105 | 120 | 15 | 0.830000000000002 | 15.2967032967033 | 2.34 | -0.00659340659341964 | 14.5239560439557 | 86 | 69.445
5 | 120 | 135 | 15 | 0.619999999999997 | 45.4065934065935 | 5.96 | 0.108131868131864 | 22.1052747252742 | 78 | 59.25
6 | 135 | 150 | 15 | 0.530000000000001 | 92.1611721611722 | Inf | 3.1687912087912 | 80.4874725274708 | 68 | 48.92
7 | 150 | 135 | -15 | 0.219999999999999 | 107.208791208791 | 7.51000000000001 | -0.272087912087915 | 43.7595604395595 | 80 | 58.925
8 | 135 | 120 | -15 | 0.579999999999998 | 27.7509157509157 | 2.18000000000001 | -0.0224175824175957 | 14.4931868131865 | 82 | 69.45
9 | 120 | 105 | -15 | 0.800000000000011 | 6.08058608058608 | 1.09 | -0.00879120879121935 | 12.6079120879118 | 91 | 75.97
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
