JysusCrack2321/AeroPendulo/control/resultados/metricas_pid_monitor_20261111_114718.csv

paso | desde | hasta | delta | tr_s | Mp_pct | ts_s | ess_grados | IAE | u_max | u_ss
1 | 0.028 | 90 | 89.972 | 3.11 | 1.18092295380785 | 5.139 | -0.0918499999999997 | 184.681599999996 | 102 | 89.845
2 | 90 | 110 | 20 | 1.29 | 6.87499999999985 | 9.32 | -0.1008 | 23.2829999999995 | 94 | 84.315
3 | 110 | 120 | 10 | 1.12 | 27.9000000000001 | Inf | -1.5706 | 11.9840999999997 | 91 | 79.31
4 | 120 | 130 | 10 | 0.640000000000001 | 37.235 | 2.44 | 0.15995 | 11.6941999999997 | 85 | 73.725
5 | 130 | 140 | 10 | 0.439999999999998 | 51.5649999999999 | 3.48 | 0.12325 | 12.8682999999997 | 78 | 66.165
6 | 140 | 145 | 5 | 0.420000000000002 | 70.3300000000002 | 2.56 | -2.49335 | 7.59799999999984 | 69 | 59.07
7 | 145 | 150 | 5 | 0.420000000000002 | 65.77 | 65.66 | 0.2468 | 48.4135999999989 | 65 | 54.79
8 | 150 | 155 | 5 | 0.459999999999994 | 68.5200000000003 | Inf | 0.00140000000000029 | 13.4263999999997 | 59 | 48.6
9 | 155 | 156 | 1 | 0.709999999999994 | 62.5500000000045 | 0.97999999999999 | -0.5046 | 3.46089999999993 | 54 | 48.8
10 | 156 | 157 | 1 | 1.71999999999998 | 84.600000000006 | 0 | 0.15255 | 2.75119999999994 | 56 | 47.96
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
