JysusCrack2321/AeroPendulo/control/resultados/metricas_pid_monitor_20261111_114718_sim.csv

paso | desde | hasta | delta | tr_s | Mp_pct | ts_s | ess_grados | IAE | u_max | u_ss
1 | -0.140659340659341 | 90 | 90.1406593406593 | 3.22 | 0.238942800019526 | 5.06 | 0.0276923076923005 | 170.541758241754 | 94 | 78.235
2 | 90 | 110 | 20 | 1.25 | 2.54945054945062 | 1.65 | -0.0153846153846224 | 20.3156043956039 | 88 | 74.345
3 | 110 | 120 | 10 | 0.75 | 15.7802197802198 | 2.16 | -0.646153846153857 | 8.10197802197785 | 82 | 69.02
4 | 120 | 130 | 10 | 0.620000000000001 | 36.7472527472529 | 3.48 | -0.188131868131888 | 11.4894505494503 | 77 | 62.775
5 | 130 | 140 | 10 | 0.530000000000001 | 62.4615384615385 | Inf | 0.724835164835156 | 15.6778021978019 | 72 | 55.58
6 | 140 | 145 | 5 | 0.32 | 121.538461538461 | Inf | -0.816263736263746 | 10.1769230769229 | 63 | 49.64
7 | 145 | 150 | 5 | 0.219999999999999 | 182.32967032967 | Inf | -0.238681318681326 | 229.423736263731 | 66 | 45.705
8 | 150 | 155 | 5 | 0.319999999999993 | 210.241758241758 | Inf | -3.65318681318683 | 43.9623076923068 | 61 | 37.075
9 | 155 | 156 | 1 | 0.0300000000000011 | 1354.28571428572 | Inf | 5.46945054945054 | 36.9406593406586 | 65 | 45.545
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
