JysusCrack2321/AeroPendulo/(commit log)

2026-11-05 Estructura inicial: firmware ESP32, procesamiento y enlace a docs del vault
    [registro_20261104_121629.csv, registro_20261104_121651.csv, registro_20261104_121841.csv, registro_20261104_121905.csv]
2026-11-05 docs: punto de montaje real en lugar de symlink
2026-11-05 docs: contenido real del proyecto (bind mount al vault)
2026-11-05 script para remontar docs tras reinicio
2026-11-05 modelado: STEP del pendulo 3D (1 solido, AP214 desde FreeCAD)
    [Estructura-Pendulo-3D.step]
2026-11-05 docs: diagramas redibujados con la geometria real del STEP (brazo 200 mm, buje D27 a 55/145 mm)
2026-11-05 docs: SVG del centro de masa de la placa (32.9 mm del pivote)
2026-11-05 modelado: ensamble FCStd brazo+brida+motor, masa y inercia calculadas
    [ensamble.FCStd]
2026-11-05 modelado: ensamble editable (Placement por pieza, motor parametrico)
    [ensamble.FCStd]
2026-11-05 modelado: brida sobre la cara exterior del buje, sin interpenetracion
    [ensamble.FCStd]
2026-11-05 modelado: brida bajo la cara inferior del brazo
    [ensamble.FCStd]
2026-11-05 modelado: MPU6050 montado sobre el brazo en el ensamble
    [ensamble.FCStd]
2026-11-05 modelado: MPU sobre la brida, coaxial al pivote
    [ensamble.FCStd]
2026-11-05 modelado: brida y MPU anclados por cara, sin holgura
    [ensamble.FCStd]
2026-11-05 modelado: MPU sobre la cara superior del buje
    [ensamble.FCStd]
2026-11-05 modelado: tornillos M3 (2 al MPU, 2 a la brida) y masa total 31.7 g
    [ensamble.FCStd]
2026-11-05 modelado: export STEP del ensamble y steps individuales por pieza
    [brazo.step, brida.step, ensamble.FCStd, ensamble.step, motor.step, mpu.step, tornillos.step]
2026-11-05 modelado: corregir posicion del motor en el STEP exportado
    [brazo.step, brida.step, ensamble.FCStd, ensamble.step, motor.step, mpu.step, tornillos.step]
2026-11-05 script para dejar permanente el bind mount de docs
2026-11-05 docs: restaurar notas del vault tras el montaje permanente
2026-11-05 tools: hook pre-commit que protege docs si el bind mount no esta activo
2026-11-05 procesamiento: registrador serial con Enter para arrancar/parar y grafica opcional
2026-11-05 procesamiento: analisis de oscilacion libre (periodo, envolvente, b)
    [registro_20261105_175149.csv]
2026-11-05 procesamiento: tramo util --desde/--hasta, picos de ambos signos y registro real
2026-11-05 docs: carpeta imagenes, diagramas corregidos (motor perpendicular, CM 24.5) y desarrollo sin linealizacion
2026-11-05 procesamiento: quitar script de analisis (se hara en Octave)
2026-11-05 docs: nota del calculo de inercia y CM
    [registro_20261104_121629.csv, registro_20261104_121651.csv, registro_20261104_121841.csv, registro_20261104_121905.csv, registro_20261105_175149.csv]
2026-11-05 firmware: sketch de prueba del motor en D25 (ESC y DC)
    [registro_20261105_181117.csv, registro_20261105_181139.csv, registro_20261105_181203.csv]
2026-11-06 firmware: prueba de motor minima (rampa arriba y abajo)
2026-11-06 firmware: pulir prueba de motor (serial activo, tope de duty, barrido apagable)
2026-11-06 datos: barrido 5 ciclos con masa de 32.5 g a 65 mm (duty 0-240)
    [registro_32.5g_barrido5.csv]
2026-11-11 control: PID del aeropendulo con lectura del MPU6050
    - firmware/control-pid: PID (Kp 1, Ki 1, Kd 0.2, Tf 0.02) sobre el AS5600
    en GPIO34, secuencia de escalones hasta 150 grados y referencia por serial;
    MPU6050 por I2C (SDA 21, SCL 22) solo de medicion, con filtro complementario
    - firmware/prueba-encoder: prueba del AS5600 analogico
    - control/: identificacion, diseno por lugar de las raices, simulacion,
    modelo de Simulink y graficas de los ensayos
    - procesamiento/: capturar_pid.py, mover.py, monitor_pid.py (monitor en vivo)
    y monitor_encoder.py, con los ensayos del banco en datos/
    [metricas_pid_escalones150_20261106_124411.csv, metricas_pid_escalones150_20261106_124411_sim.csv, metricas_pid_escalones150_20261106_124828.csv, metricas_pid_escalones150_20261106_124828_sim.csv, metricas_simulacion.csv, pid_escalones150_20261106_115520.csv, pid_escalones150_20261106_120007.csv, pid_escalones150_20261106_120352.csv]
2026-11-11 control: figuras y metricas del ensayo con monitor_pid (11 nov)
    [metricas_pid_monitor_20261111_114718.csv, metricas_pid_monitor_20261111_114718_sim.csv]
